yefu1681668/stm32-weather-clock/README.md

# STM32 智能天气时钟（FreeRTOS 版）

基于 **STM32F103C8T6** 的桌面天气时钟：ESP32-C3（AT 固件）联网获取天气与时间，1.8" ST7735 彩屏显示时钟、气温与湿度，RTC 独立走时，FreeRTOS 多任务调度。

本项目为「裸机版天气时钟」的 FreeRTOS 重构版本，同时也是后续 **OTA 远程升级** 改造的起点。

> **状态：全部功能与多任务架构均已在真机验证通过**（2026-11-10），详见文末「真机验证记录」与「演示：断网 A/B 对比」。

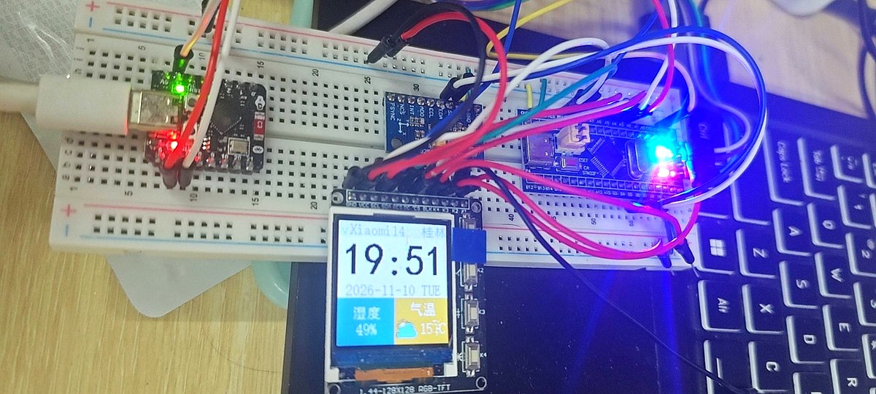
[picture p1: docs/hardware.jpg]
实物接线：STM32F103C8T6 + ST7735 彩屏 + ESP32-C3 面包板系统


> 实物照片：面包板上的 C8T6、ST7735 彩屏、ESP32-C3 与杜邦线连接。

---

## 功能特性

- **联网天气**：ESP32-C3 通过 AT 指令连接 2.4 GHz WiFi，向心知天气请求实况（天气现象、温度）与当天湿度
- **SNTP 对时**：启动时用 `AT+CIPSNTPTIME?` 取本地时间写入 RTC；RTC 由 LSE 32.768 kHz 晶振走时，掉电保持
- **界面**：128×128 分区布局 —— 状态栏（WiFi 名 + 城市）、48 px 大字号时间、日期行、湿度面板、气温面板
- **湿度**：来自天气 API 的**城市相对湿度**（板上没有湿度传感器），显示如 `49%`
- **气温**：天气 API 实况温度 + 对应的 24×24 天气图标（晴 / 多云 / 阴 / 雨 / 雪 / 风）
- **三任务架构**：`ui_task` / `net_task` / `heartbeat_task` 分工，队列传数据、互斥量保护屏幕、二值信号量做启动闸门
- **断网不冻屏**：AT 指令最长 20 s 的等待被隔离在低优先级网络任务，联网卡住时时间、冒号与 LED 心跳照常
- **栈水位监控**：每 20 s 用 `uxTaskGetStackHighWaterMark()` 采样，低于 64 word 时 LED 快闪告警

> 说明：MPU6050 驱动仍在工程中并完成了初始化，但当前界面不读取它 —— 它的温度是**芯片结温**（比室温高 10 ℃ 以上），不是环境温度，显示出来会误导，因此已停用。姿态自动翻转功能尚未实现。

## 硬件清单

| 器件 | 型号 / 规格 | 说明 |
|---|---|---|
| 主控 | STM32F103C8T6 | 64 KB Flash / 20 KB RAM，72 MHz |
| 显示 | ST7735 1.8" TFT | 128×128，SPI 接口，RGB565 |
| 联网 | ESP32-C3 开发板 | 预烧精简版 AT 固件，UART 115200，自带 Type-C 供电 |
| 姿态 | MPU6050 | 六轴，软件 I2C（当前仅初始化，未使用读数） |
| 存储 | W25Q80（1 MB SPI Flash） | 存放 6 张天气图标，见下文「图标外置到 W25Q」 |
| 走时 | 32.768 kHz 晶振 | 接 PC14 / PC15，供 RTC 使用 |
| 下载 | ST-Link V2 | SWD 四线 |

## 接线表

引脚定义直接取自驱动代码（`driver/` 下各文件的 `#define`），与实际接线一致。

### ST7735 显示屏（SPI1）

| 信号 | 引脚 | 说明 |
|---|---|---|
| SCK | PA5 | SPI1 时钟，18 MHz（72 MHz ÷ 4） |
| MOSI | PA7 | SPI1 数据输出 |
| CS | PA4 | 片选，低有效 |
| DC | PB1 | 命令/数据选择 |
| **RES** | **PB0** | **硬复位，必须接！漏接 = 背光亮但纯白屏** |
| BLK | PB10 | 背光，高电平点亮 |

> SPI1 配置为 Mode 3（CPOL=1, CPHA=2Edge）、单线发送主模式、软件 NSS。屏幕只写不读，因此未占用 MISO（PA6）。
> 像素数据当前使用**阻塞轮询发送**（`ST7735_USE_DMA = 0`），不经过 DMA，避免 DMA 未启动时永久死等。

### ESP32-C3（USART2）

| 信号 | 引脚 | 说明 |
|---|---|---|
| TX | PA2 | STM32 → ESP32 |
| RX | PA3 | ESP32 → STM32 |

> 波特率 115200，中断接收，接收缓冲 4096 B。注意不是 PA9/PA10（那是 USART1）。
> **TX / RX 必须交叉**，且 ESP32 与 STM32 **必须共地**。

### W25Q 图标 Flash（软件 SPI，独立于屏）

| 信号 | 引脚 | 说明 |
|---|---|---|
| CS | PB12 | 片选，低有效 |
| CLK | PB13 | 软件 SPI 时钟（Mode 0） |
| DI / MOSI | PB15 | 主 → 从 |
| DO / MISO | PA6 | 从 → 主 |
| VCC / GND | 3.3V / GND | **不能接 5V** |
| WP / HOLD | 3.3V 或悬空 | 接地会变成只读芯片 |

> 故意没有用硬件 SPI2：SPI1 已被显示屏占用且配置为单向 Mode 3，另开 SPI2 要牵动 DMA 与中断；图标只在刷新时才读，软件 SPI 的速度完全够，接线也更容易复现。
> 模块丝印常写 `DI` / `DO` 而不是 `MOSI` / `MISO`：**DI 是 MOSI，DO 是 MISO**，接反就是读 ID 全 0。

### MPU6050（软件 I2C）

| 信号 | 引脚 |
|---|---|
| SCL | PB6 |
| SDA | PB7 |

### 其他

| 器件 | 引脚 |
|---|---|
| 板载 LED | PC13 |
| RTC 晶振 | PC14 / PC15（LSE） |

## 软件架构

```
main()
 ├─ HAL_Init() / SystemClock_Config()       72 MHz（HSE 8 MHz × 9）
 ├─ MX_GPIO_Init() / MX_USART1_UART_Init()
 └─ freertos_start()
      ├─ xQueueCreate(6, weather_msg_t)     网络 → UI 的数据快照队列
      ├─ xSemaphoreCreateMutex()            保护 ST7735（两个任务都要写屏）
      ├─ xSemaphoreCreateBinary()           屏幕就绪闸门，初值 0
      ├─ esp_at_set_wait_hook(net_wait_1ms) 把驱动层 1ms 忙等换成 vTaskDelay(1)
      ├─ xTaskCreate(start_task) / vTaskStartScheduler()    TICK = 1000 Hz
      └─ start_task 建完三个任务后 vTaskDelete(NULL)
           ├─ ui_task         P3  640 word   只画屏 + 500 ms 时间节拍
           ├─ net_task        P2  384 word   WiFi / SNTP / HTTP，只发队列
           └─ heartbeat_task  P4  128 word   1 Hz LED + 20 s 栈水位采样
```

启动顺序（**顺序和闸门都很重要**）：

```
ui_task:   led_init → st7735_init → rtc_init → mpu6050_init
        → 画静态框架 / 状态栏 / 日期 / 时间 / 湿度面板
        → xSemaphoreGive(g_lcd_ready)          放行 net_task
        → 循环：非阻塞 xQueueReceive + 每 500 ms 刷时间/冒号

net_task:  xSemaphoreTake(g_lcd_ready)         屏没初始化好之前绝不碰屏
        → net_init_network()（进度行，写屏前先拿 g_lcd_mutex）
        → 依次发 MSG_WIFI_STATUS / MSG_NET_DONE / MSG_WEATHER / MSG_HUMIDITY
        → 循环：每 10 min 刷天气 + 对时，每 60 min 刷湿度
```

| 同步对象 | 类型 | 解决的问题 |
|---|---|---|
| `g_weather_q` | 队列（深度 6） | 网络数据与界面解耦；UI 用 `xQueueReceive(..., 0)` 非阻塞取，绝不因等网络而停摆 |
| `g_lcd_mutex` | 互斥量 | `net_task` 画开机进度、`ui_task` 画主界面共用 SPI，避免半帧交错 |
| `g_lcd_ready` | 二值信号量 | ESP32 串口在联网流程里才初始化，闸门保证进度行不会写进一块还没初始化的屏 |

**为什么做这次拆分（真实缺陷，不是为了用 RTOS 而用）**：`esp_at_send_command()` 的等待是 `while (rxready && timeout--) delay_ms(1)`，`AT+CWJAP` 上限 20 s、HTTP 10 s。原架构网络与画屏挤在同一个 `ui_task` 里，请求一卡就整屏冻结、时间不跳、LED 不闪。

**驱动层保持零 RTOS 依赖**：`esp_at.c` 不 include 任何 RTOS 头文件，只暴露一个 `esp_at_set_wait_hook()` 函数指针；任务层注册 `net_wait_1ms()`（`vTaskDelay(1)`），把每 1 ms 的忙等变成挂起一个 tick。系统 tick 是 1 kHz，任务总在 tick 边界被唤醒，超时仍按毫秒计。固定延时（500 / 2500 / 1000 ms）也走同一路径。

> **踩过的坑：低优先级饥饿。** 首版把 `heartbeat_task` 放在 P1（最低），真机出现「冒号照常闪、PC13 LED 完全不闪」——因为 `net_task`(P2) 忙等时始终就绪，`ui_task`(P3) 能抢占，而 P1 一次都调度不到。修复是三管齐下：等待钩子让出 CPU、心跳提到 P4（存活指示器必须独立于业务负载）、并给三个 `xTaskCreate` 补返回值检查（堆不足时以 100 ms 快闪报警，不再静默失败）。

任务参数：优先级 5 级（`configMAX_PRIORITIES = 5`）、最小栈 128 word、堆 8 KB（`heap_4`，三个任务栈与同步对象均从中动态分配）、`configUSE_MUTEXES = 1`、`INCLUDE_uxTaskGetStackHighWaterMark = 1`。

> 曾经的顺序 bug：`ui_update_weather()` 排在串口初始化之前，等于把 AT 命令发给一个还没打开的串口，会白等 10 秒，表现为「橙色面板空白」。现在已修正，并由 `g_lcd_ready` 从机制上杜绝。

### 图标外置到 W25Q（2026-11-11）

6 张天气图标原本是 `const uint16_t` 数组编进固件，**27 648 B 占掉 APP 分区的一大半**，导致 47 KB 的 OTA APP 分区装不下（超 104 B）。改造分三步：

1. **写驱动**：`driver/w25q/` —— 软件 SPI（Mode 0）、读 / 页写 / 4 KB 扇区擦除 / 跨页自动拆分 / 忙等待超时，全部带返回值，不静默失败。
2. **一次性烧录**：临时固件把 6 张图标（`icons.bin` 紧凑布局）写进 `0x010000` 并**逐字节读回比对**，屏上显示 `ICON OK 27648B` 即通过。烧完这段代码已删除，需要重烧时从提交 `357c842` 取回 `mdk/app/icon/*.c` 与旧版 `freertos_demo.c`。
3. **改绘图**：`draw_icon_flash()` 按**行**从 W25Q 读（每行 48 px = 96 B），2:1 抽样画成 24×24。**RAM 只多 96 B** —— 整张 4 608 B 放不进 C8T6 的 20 KB，六张 27 KB 更不可能。

存储布局（`app/icons_flash.h`，与 `icons_index.h` 一致）：

| 地址 | 内容 | 大小 |
|---|---|---|
| `0x000000` | 保留（参数 / 元数据） | 64 KB |
| `0x010000` | 6 张图标，间隔 `0x1200` | 27 648 B |
| `0x020000` | OTA 固件暂存区（已占位，待用） | ≤ 47 KB |

1 MB 的 W25Q80 用不到 15%，容量不是瓶颈。开机只读一次 JEDEC ID：不通就在日期行打红字 `W25Q FAIL`，通路则完全不打扰界面，图标画不出来时自动退化为「只有温度没有图标」的排版，不会白块也不会死机。

### OTA BootLoader 第一步（2026-11-11）

图标搬出去腾出空间后，开始把固件拆成两级。**这一步只做"能启动、能跳转"，升级通路还没接。**

内部 Flash 分区：

| 区域 | 起始地址 | 大小 | 当前占用 |
|---|---|---|---|
| Boot | `0x08000000` | 16 KB | 8 128 B（49.6%） |
| APP | `0x08004000` | 47 KB（`0xBC00`） | 22 564 B（46.9%） |
| 参数页 | `0x0800FC00` | 1 KB | 升级标志 / `boot_try` 计数 |

Boot 主流程：`HAL_Init` → 时钟（HSE 起不来就 10 Hz 快闪报错，不装死）→ 读参数页 → 校验 APP 起始处的 MSP/PC 是否落在 `0x08004000`~`0x20005000` 内 → **500 ms 常规窗口**（LED 5 Hz 快闪，可手动发 `U` 请求升级）→ 校验通过且无请求则跳转。

跳转做了三件容易被忽略的事：`__disable_irq()`、`SCB->VTOR = APP 地址`、`__set_MSP(APP 栈顶)` 之后才 `((void(*)(void))复位向量)()`。APP 侧 `main()` 开头也重设一次 `VTOR`，这样 APP 单独烧到 `0x08000000` 调试时行为不变。

**Boot 故意不驱动屏幕。** 它只有 8 KB，没有 ST7735 驱动，也不碰 PB10（背光）；`st7735_bl_on()` 是 APP 的 `st7735_init()` 最后一句。所以**只烧 Boot、或 APP 区还没有有效固件时，上电屏幕是全黑而不是白屏** —— 这是设计而非故障，此时唯一的指示是 PC13：

| PC13 表现 | 含义 |
|---|---|
| 5 Hz 快闪 0.5 秒后转为 APP 的 1 Hz | 正常：Boot 跑通并跳转成功 |
| 2 Hz 慢闪 | 在升级窗口里等上位机 / 正在收固件 |
| 一直 5 Hz 慢闪不停 | APP 校验不过（没烧、或没烧到 `0x08004000`）；发 `U` 可重新升级救砖 |
| 10 Hz 快闪 | 时钟起不来（HSE 异常） |

接 CH340 到 PA9/PA10（115200）可以看到 Boot 日志：版本、参数状态、APP 地址与有效长度、`jumping to app...`。Boot 用寄存器直接操作 USART1（`boot/boot_uart.c`），因为本工程 HAL 的 UART 模块是关着的 —— 这样做也省了 1~2 KB ROM。

> 第①步最初是固定等 3 秒，每次开机都白等；第②步改成 500 ms 按需等待，详见下节。

### OTA BootLoader 第二步：升级请求（2026-11-11）

第①步每次开机都要在 Boot 里白等 3 秒，而且**没有任何办法让 APP 主动回到 Boot**。这一步把两件事一起解决。

**三条进入升级等待的路径**

| 触发方式 | 适用场合 |
|---|---|
| APP 运行时串口发 `U` | 正常升级：APP 写参数页 `upgrade_req=1` → `NVIC_SystemReset()` → Boot 读到标志停住 |
| 上电后 500 ms 内串口发 `U` | APP 已经跑不起来时的手动入口（Boot 自己也能收命令） |
| 参数页里预先写好 `upgrade_req=1` | 上位机 / 第③步流程使用 |

**为什么标志必须跨复位存在**：复位会清空 RAM，Boot 和 APP 之间唯一的"信箱"就是 `0x0800FC00` 那 32 B 参数页。APP 侧直接复用 `boot/boot_param.c` + `boot_crc.c` + `boot_flash.c`（工程里新建 `Boot/Shared` 分组，IncludePath 加 `..\boot`），两边共用同一份结构体和 CRC，不会出现"APP 按 A 格式写、Boot 按 B 格式读"的错位。

**标志是一次性的**：Boot 一读到 `upgrade_req=1` 就立刻清 0 写回，再进入等待。不清的话升级结束后每次复位都会再停一次，板子就永远回不了 APP。清失败时**直接忽略这次请求**（宁可丢一次升级，也不让每次开机白等 30 秒）。正常开机绝不擦写参数页，避免磨损 Flash。

**超时回退**：`BOOT_UPGRADE_WAIT_MS = 30 s` 是「等第一个字节」的窗口；第③步已把它换成真正的固件接收状态机，30 s 内没等到上位机就 `timeout -> fallback to app`，误触发一次也不会变砖。

| 常量 | 值 | 位置 |
|---|---|---|
| `BOOT_WAIT_MS` | `3000 → 500` ms | `boot/boot_cfg.h` |
| `BOOT_UPGRADE_WAIT_MS` | `30000` ms | `boot/boot_cfg.h` |
| `BOOT_CMD_CHAR` | `'U'`（大小写都认） | `boot/boot_cfg.h` |

**APP 侧实现**（`mdk/app/app_upgrade.c`）：USART1 RXNE 中断只置一个 `volatile` 标志，不调用任何 FreeRTOS API；`heartbeat_task` 从 1 s 一次改为 **20 × 50 ms** 的节拍（LED 仍是 1 Hz），每 50 ms 查一次标志，命中就挂起调度器 → 擦写参数页 → `NVIC_SystemReset()`（不用关中断：APP 的 HAL 时基是 TIM7 中断，Flash 擦写靠 `HAL_GetTick()` 判超时，关中断会把时基冻住）。RX 脚 PA10 补了上拉，避免没接 CH340 时浮空噪声造成误触发。

**验证方法**（需要 CH340：TX→PA10、RX→PA9、共地，115200 8N1）

1. 两个 hex 都重烧，正常上电 → **约 0.5 秒**后屏亮（原来 3 秒），串口打印 `waiting 500 ms ('U' to upgrade)...` 后 `jumping to app...`。
2. 天气时钟跑起来后，串口助手发送一个字符 `U` → APP 打印 `[OTA] upgrade requested -> reboot to BootLoader` 并立刻复位。
3. Boot 打印 `upgrade_req found -> stay in boot`、`waiting for firmware 30000 ms...`，PC13 改为 **2 Hz 慢闪**，屏幕保持全黑（Boot 不驱动屏）。
4. 第②步当时是「30 秒后 `timeout -> fallback to app` 跳回天气时钟」；第③步之后这个窗口会被固件接收状态机接管，没接上位机时才走同样的超时回退。

> 没接 CH340 也能验证第 1 条：上电到屏亮明显变快，就说明 500 ms 窗口生效了。

### 11-14 真机串口日志与一个已知陷阱

烧完两个 hex 后，SSCOM 5.13.1 / COM14 / 115200 8N1 抓到（完整的一轮）：

```
===== OTA BootLoader v0.1 =====
param: fresh upgrade_req=0, boot_try=0
app @0x08004000 valid, size=47352
waiting 500 ms ('U' to upgrade)...
jumping to app...
```

逐行读：参数页是出厂态（`fresh`）、没有待处理的升级请求；`0x08004000` 的向量表合法；**`waiting 500 ms` 证明新版 Boot 确实在跑**，`BOOT_WAIT_MS` 已从 3 s 降到 500 ms；最后成功跳转，约 0.5 s 屏亮、天气时钟正常。

> 抓到两轮启动日志，第一轮少了 `waiting 500 ms` 那一行。这行在代码里是无条件打印的，所以大概率是 ST-Link 下载复位时 CH340 重新枚举丢了几个字节，不是固件问题。

**`size=47352` 不是固件大小，别被它骗了。** 真实 APP 只有 22 564 B。`boot_app_measure_size()` 扫的是「APP 区里最后一个非 0xFF 字节」的位置，而 Keil 的 Erase Sectors 只擦固件实际占用的页，后面还残留着迁到 `0x08004000` 之前那版 48 KB 固件的残骸，于是扫描一路顶到接近 `0xBC00`。`boot_app_check()` 只看向量表的 MSP / PC，跟这个数字无关，所以跳转完全正常。

已把日志措辞改成 `valid, scan_end=`，并在 `boot_jump.c` 里写明限制。**对第③步的硬约束**：CRC32 校验范围、擦除页数、从 W25Q 复制多少字节，都必须由上位机协议头里的 `length` 决定（或写进 W25Q 暂存区的固件头），**绝不能靠扫描 0xFF 推断长度** —— 否则会把残留垃圾一起算进去，校验永远对不上。

**验证 2 同日 16:54 也已通过。** APP 运行时串口发单个字符 `u`（SSCOM 勾了「加回车换行」，状态栏 `S:3` 说明实际发出 `u\r\n` 共 3 字节），抓到的关键信号：

```
[OTA] upgrade requested -> reboot to BootLoader
===== OTA BootLoader v0.1 =====
param: ok, upgrade_req=1, boot_try=0
...
upgrade_req found -> stay in boot
waiting for firmware 30000 ms...
timeout -> fallback to app
jumping to app...
```

| 信号 | 证明 |
|---|---|
| `[OTA] upgrade requested` | APP 的 USART1 RXNE 中断收到命令；代码等 `TC` 标志把提示发完才复位，这行不会缺字 |
| `param: ok, upgrade_req=1` | 参数页写入成功、magic + CRC 合法，**标志跨复位活了下来**（`fresh` → `ok`） |
| `upgrade_req found -> stay in boot` | Boot 读到标志、清 0 写回、进入升级等待 |
| `waiting for firmware 30000 ms...` | 30 s 窗口生效；PC13 2 Hz 慢闪、屏幕全黑（Boot 不驱动屏） |
| `timeout -> fallback to app` + `jumping to app...` | 请求了但没接上位机也能自己回 APP，**误触发不变砖** |

发小写 `u` 也能命中：`BOOT_CMD_CHAR` 是 `'U'`，Boot 与 APP 两处判断都同时接受 `'U' + 0x20`。这一轮日志里的 `size=` 仍是旧措辞，因为烧的还是上一版 Boot —— 上面 `scan_end` 的改动只是注释 / 文案，不影响功能，不用专门重烧。

**再按一次 RESET 可以做第三个确认**：参数页应显示 `param: ok, upgrade_req=0`（`ok` 而非 `fresh`），证明那个一次性标志确实被 Boot 清掉了，下次开机不会又白等 30 秒。

### OTA BootLoader 第三步：串口固件升级（2026-11-14）

第②步那个 30 秒窗口只是空等，这一步把它换成真正的升级状态机：**串口收固件 → W25Q 暂存 → CRC32 校验 → 擦写 APP 区 → 复位**。

**为什么必须经过 W25Q**：C8T6 只有 20 KB SRAM，而一版 APP 固件 22 564 B，根本不可能整包收进 RAM。所以每收到一帧就立刻顺序写进外部 Flash，收完再从 W25Q 流式读回来算 CRC32。这个约束反而带来一个关键安全性质 —— **CRC32 通过之前，APP 区一个字节都不会被擦**：传坏包、断线、中途断电，板子都还留着原来能跑的固件。

**镜像布局**（W25Q `0x020000` 起，与图标区 `0x010000` 隔着 64 KB）

| 偏移 | 大小 | 内容 |
|---|---|---|
| `+0x00` | 32 B | 镜像头：`magic "OTA2"` / `length` / `crc32` / `version` / 保留 |
| `+0x20` | N B | 固件原始数据（从 `0x08004000` 起的连续映像） |

`length` 只能来自这个头（上位机解析 Intel HEX 时按「最后一个写过的地址」计算），**绝不靠扫 0xFF 推断** —— 这正是 11-14 日志里 `size=47352` 那个坑。

**串口分帧**（115200 8N1）

```
SOF 0xA5 | TYPE 1B | SEQ 2B(小端) | LEN 2B(小端) | PAYLOAD <=128B | CRC16 2B(小端)
```

| TYPE | PAYLOAD | Boot 的动作 |
|---|---|---|
| `0x01` HEAD | 32 B | 校验 magic / length → 擦暂存扇区 → 把头写进 W25Q |
| `0x02` DATA | ≤128 B | 顺序写 W25Q `+0x20+offset`，回 ACK |
| `0x03` END | 0 B | 校验字节数收齐后进入提交流程 |

应答是单字节：`0x06` ACK / `0x15` NAK（重发本帧）/ `0x07` DONE（成功，即将复位）/ `0x1B` ABORT。CRC16-CCITT-FALSE（poly `0x1021`，init `0xFFFF`）覆盖 `TYPE..PAYLOAD`，不含 SOF；**整包完整性由 CRC32 负责**。上位机最多重发 3 次，Boot 遇到「重复上一帧」直接回 ACK，能容忍 ACK 丢失。

**为什么帧内绝不 `HAL_Delay`**：F1 的 USART 没有 FIFO，RXNE 只锁存 1 个字节，115200 下每 86.8 µs 就来一个。收帧途中插 10 ms 延时会把后面整帧丢光，所以从 SOF 开始的每个字节都是紧轮询读取，只有「还没进帧、在等 SOF」时才闪 LED。上位机也严格逐帧等 ACK，绝不连发。

**提交流程**（`boot/boot_ota.c` 的 `ota_commit()`）

1. 从 W25Q `+0x20` 起按 256 B 分块流式读，累加 CRC32，与镜像头比对。不符 → 打印 `CRC MISMATCH` 直接返回，**APP 区未动**。
2. `boot_flash_erase_range(APP_START_ADDR, APP_MAX_SIZE)` 擦**整个** APP 区 47 页，而不是只擦 `length` 覆盖的页 —— 顺带清掉迁址前那版 48 KB 旧固件的残骸，所以升级后开机日志的 `scan_end` 会从 47352 变成真实的 22564。
3. 从 W25Q 逐块读、按半字写回内部 Flash。
4. 内部 Flash 是内存映射的，直接按地址读回来**再算一次 CRC32**，抓「`HAL_FLASH_Program` 返回 OK 但实际没写进去」。
5. `boot_app_check()` 复核 MSP / PC → 参数页记 `app_size` / `app_crc32` / `boot_try=0` → 回 DONE → `NVIC_SystemReset()`。

**救砖入口**：万一擦写中途失败导致 APP 无效，Boot 会停在 5 Hz 慢闪；此时串口发一个 `U` 就能重进升级状态机再传一次，不需要 ST-Link。

| 文件 | 作用 |
|---|---|
| `boot/boot_ota.c/.h` | 分帧状态机、CRC16、W25Q 暂存、提交流程 |
| `boot/boot_uart.c/.h` | 从 `boot_main.c` 抽出的 USART1 底层，新增带超时的阻塞读 |
| `boot/delay.c/.h` | 让 `mdk/driver/w25q/w25q.c` **一行不改**就能被 Boot 复用（`delay_ms` → `HAL_Delay`） |
| `boot/boot_main.c` | 30 s 空等换成 `boot_ota_run()`；末尾 `while(1)` 加救砖入口 |
| `boot/boot_cfg.h` | 协议常量、`OTA_STAGING_ADDR 0x020000`、版本 v0.2 |
| `boot/startup_stm32f103xb.s` | 栈 1 KB → 2 KB（256 B 读缓冲 + 136 B 帧结构 + HAL 擦写调用栈） |
| `mdk_boot/BootLoader.uvprojx` | 新增 `W25Q (shared with APP)` 分组，直接引用 `..\mdk\driver\w25q\w25q.c` |

**上位机**：`tools/ota_send.py` + `tools/ota_uart.py`。本机 pip 装不上 pyserial，所以串口层用 `ctypes` 直接调 Windows `kernel32`（`CreateFileW` / `SetCommState` / `ReadFile` / `WriteFile`），**零第三方依赖**。脚本负责解析 Keil 的 Intel HEX、加镜像头、发 `U` 触发、逐帧等 ACK，并实时把 Boot 日志打印出来 —— 应答是控制码（`0x06`/`0x15`/`0x07`/`0x1B`），日志全是可打印 ASCII，两者不会混淆。

```bash
python tools/ota_send.py --port COM14
python tools/ota_send.py --port COM14 --hex mdk/Objects/Freertos的嵌入式智能天气时钟.hex
```

默认升级包就是**当前这份 APP 的 hex 还原出来的 bin**（22 564 B / 177 帧 / CRC32 `0xC05D9226`）。功能不变，但完整验证了「擦 → 写 → 读回校验 → 复位 → 跳转」整条链，而且 `scan_end` 的变化是肉眼可见的证据。

**验证方法（代码完成，真机验证待补）**

1. 只重烧 **Boot v0.2**（`mdk_boot`，`F7` → `F8`，Erase Sectors）；APP 源码与 hex **逐字节未变，不用重烧**。
2. 关掉串口助手，接好 CH340（TX→PA10 / RX→PA9 / 共地），运行 `python tools/ota_send.py --port COM14`。
3. 期望日志：`[OTA] W25Q id=0x00EF4014` → `[OTA] HEAD len=22564` → 每 4 KB 一条 `recv ...` → `[OTA] crc32 ok, erasing APP 47 KB...` → `[OTA] write 22564 B, readback crc ok` → `[OTA] DONE, resetting...`。
4. 复位后：`===== OTA BootLoader v0.2 =====`、`app @0x08004000 valid, scan_end=22564`（不再是 47352）、`jumping to app...`，天气时钟界面正常。

> 尚未验证：坏包 / 断电时「APP 区不被动」这条安全性，以及第④步的 `boot_try` 失败保护。

## 目录结构

```
weather_clock/
├── Core/                    CubeMX 生成的应用与 HAL 配置
│   ├── Inc/                 main.h / FreeRTOSConfig.h / HAL 配置
│   └── Src/                 main.c / gpio.c / usart.c / stm32f1xx_it.c
├── Drivers/                 STM32F1 HAL 库 + CMSIS（ST 官方，未改动）
├── FreeRTOS/                内核源码（tasks / queue / list）+ heap_4 + ARM_CM3 port
├── docs/                    实物照片 + 断网 A/B 对比演示 GIF
│   ├── hardware.jpg / screen.jpg
│   └── demo-offline.gif / demo-online.gif
├── boot/                    OTA BootLoader 源码（编到 0x08000000，16 KB 分区）
│   ├── boot_main.c          主流程：时钟 → 参数 → 500 ms 窗口 → 升级状态机/跳转
│   ├── boot_jump.c          MSP/PC 合法性检查 + 关中断 + 设 VTOR + 跳转
│   ├── boot_flash.c         内部 Flash 擦写 + APP 有效长度测量
│   ├── boot_param.c         参数页（0x0800FC00）读写
│   ├── boot_crc.c           CRC32（poly 0xEDB88320，位运算版省 ROM）
│   ├── boot_ota.c           第③步：分帧接收 / W25Q 暂存 / 校验 / 擦写 APP
│   ├── boot_uart.c          USART1 寄存器直写（日志 + 带超时收字节）
│   ├── delay.c              Boot 侧延时适配层，复用 APP 的 w25q.c
│   └── startup_stm32f103xb.s  Boot 专用启动文件（栈 2 KB）
├── mdk/                     Keil MDK 工程（APP）
│   ├── Freertos的嵌入式智能天气时钟.uvprojx
│   ├── app/                 应用层：天气解析、字库、开机动画、图标布局、app_upgrade.c
│   ├── driver/              外设驱动：st7735 / esp-at / mpu6050 / w25q / led / rtc
│   ├── user/                任务实现 freertos_demo.c、本地配置 wifi_config.h
│   └── Boot/Shared 分组     复用 ../boot 的参数页代码（同一份结构体与 CRC）
├── mdk_boot/                Keil MDK 工程（Boot，独立工程）
│   └── BootLoader.uvprojx   含 W25Q (shared with APP) 分组
└── tools/                   OTA 上位机（零第三方依赖）
    ├── ota_send.py          解析 hex / 加镜像头 / 分帧发送 / 打印 Boot 日志
    └── ota_uart.py          ctypes 调 Windows kernel32 的串口层
```

工程文件使用 `..\Core`、`..\Drivers`、`..\FreeRTOS` 相对路径引用上层目录，因此**必须保持上述目录结构**，不可只复制 `mdk/`。

## 编译与烧录

1. **配置本地参数**：编辑 `mdk/user/wifi_config.h`，填入自己的 WiFi 账号与心知天气 API key：

   ```c
   #define WIFI_CFG_SSID        "你的WiFi名"          /* 必须 2.4 GHz */
   #define WIFI_CFG_PWD         "你的WiFi密码"
   #define WEATHER_CFG_API_KEY  "你的心知天气key"      /* seniverse.com 免费注册 */
   #define WEATHER_CFG_CITY     "guilin"
   ```

   > 仓库中该文件是占位符版本（`YOUR_WIFI_SSID` 等），不填无法联网，但能正常编译。照片与录屏里的 SSID 是实机调试用的真实热点名，配置文件本身不含任何真实凭据。

2. **打开工程**（现在是两个独立工程，先 Boot 后 APP）：
   - Boot：`mdk_boot/BootLoader.uvprojx`，IROM 起始 `0x08000000`，大小 `0x4000`
   - APP：`mdk/Freertos的嵌入式智能天气时钟.uvprojx`，IROM 起始 `0x08004000`，大小 `0xBC00`
3. **编译烧录**：`F7` 编译 → `F8` 下载（ST-Link，BOOT0 接 GND）。**两个都必须烧**，只烧 Boot 屏幕不会亮（Boot 不驱动屏幕，详见下节）。首次打开 Boot 工程如果弹 `No ULINK2/ME Device found`，是调试器默认选中了 ULINK2，在 `Options for Target → Debug → Use:` 里改成 `ST-Link Debugger` 即可。
4. **上电观察**：PC13 快闪约 0.5 秒（Boot 500 ms 窗口）→ 屏幕亮起、中间提示行依次走 `1/4 Init ESP...` → `2/4 STA Mode...` → `3/4 <SSID>...` → `4/4 SNTP Sync...` → 进入时钟界面，LED 转为稳定 1 Hz 慢闪

### 串口 OTA 升级（不用 ST-Link）

第③步做完之后，改 APP 不必再动 ST-Link：Boot 自己收固件、自己擦写 APP 区。

```bash
# 1. 关掉串口助手（COM 口只能被一个程序占用）
# 2. 确认 CH340：TXD->PA10、RXD->PA9、GND 共地
python tools/ota_send.py --port COM14
```

脚本会自动解析 `mdk/Objects/Freertos的嵌入式智能天气时钟.hex`、加 32 B 镜像头、发 `U` 让板子回 Boot、逐帧发送并实时打印 Boot 日志。**零第三方依赖**（串口层用 `ctypes` 调 Windows 系统 API）。

> Boot 只在改 `boot/` 目录时才需要用 ST-Link 重烧；日常改天气时钟只要编译 APP 生成新 hex，再跑一次上面的命令即可。协议细节与验证清单见「OTA BootLoader 第三步」。

### 排障提示（都是真机踩过的坑）

| 现象 | 原因与排查方向 |
|---|---|
| **背光亮、屏幕纯白** | **头号原因：RES 没接 PB0**，或 RES/DC 接反（PB0 与 PB1 是相邻两孔）。屏没被硬件复位唤醒，发什么命令都不响应 |
| 背光亮、有画面但卡住 | 检查 `net_init_network()` 顺序，AT 命令不能发在串口初始化之前 |
| 屏幕全黑 | 量 PB10 背光是否为高、VCC 是否 3.3 V |
| 顶部彩条都画不出来 | 用 `st7735_probe_bars()` 做最小路径测试（绕过上层绘图）；能出彩条 = 屏与 SPI 正常，问题在绘图层 |
| `ESP rx=0000` | ESP32 一个字节都没回：查 TX/RX 交叉、共地、EN/BOOT 脚、供电（不要用 ST-Link 的 3.3 V 带 ESP） |
| 时间显示 `08:xx` | `AT+SYSTIMESTAMP?` 不被固件支持导致时间戳为 0（1970+8h）。本工程已改用 `AT+CIPSNTPTIME?` |
| 图标是黑底 + 颜色错乱 | RGB565 图标数组是**小端**存放，且 `0x0000` 表示透明。本工程已按小端解析并跳过纯黑 |
| 湿度显示 `--%` | 湿度来自 `daily.json`，联网失败或接口未返回时会保持占位符，属正常容错 |
| 冒号闪但 LED 完全不闪 | 低优先级饥饿：`net_task` 长忙等期间心跳任务抢不到 CPU。本工程已用等待钩子 + 心跳 P4 修复 |
| LED 上电后 100 ms 快闪不停 | `ucHeap` 不足导致某个 `xTaskCreate` 失败，需扩堆或缩任务栈 |

> **AT 固件差异**：实测这颗 ESP32-C3 是裁剪版乐鑫 AT 固件，支持 `AT` / `CWMODE` / `CWJAP` / `CIPSNTPCFG` / `CIPSNTPTIME?` / `HTTPCGET`，但不支持 `AT+GMR` / `AT+VER` / `AT+CIPSTA?` / `AT+SYSTIMESTAMP?`。因此初始化采用「先用 `AT` 探活，其余尽力而为」的容错写法，不因某条可选命令报错就判定模组失联。

## 资源占用（实测，Keil V5.06 编译结果）

```
Program Size: Code=17948  RO-data=4356  RW-data=260  ZI-data=17812
```

| 项目 | 占用 | 总容量 | 使用率 |
|---|---|---|---|
| Flash（Code + RO + RW） | 22 564 B ≈ **22.0 KB** | 64 KB | 34.4% |
| RAM（RW + ZI） | 18 072 B ≈ **17.6 KB** | 20 KB | 88.2% |

> 数值含本地 WiFi 账号字符串，换用不同长度的 SSID 会有几十字节偏差。相比图标外置完成时（21 128 B）多出的约 1.4 KB，是第②步的参数页写入、CRC32、串口中断与升级请求逻辑。

**Boot 侧（`mdk_boot/BootLoader.uvprojx`）**

```
Program Size: Code=7788  RO-data=320  RW-data=20  ZI-data=2116
```

| 项目 | 占用 | 总容量 | 使用率 |
|---|---|---|---|
| Boot Flash | 8 128 B | 16 KB | 49.6% |
| Boot RAM | 2 136 B | 20 KB | 10.4% |

Boot 只链了 HAL 的 GPIO / RCC / FLASH / PWR / CORTEX 五类模块，没链 UART（串口用寄存器写）、没链屏驱动、没链 FreeRTOS。第③步把分帧状态机 + 软件 SPI Flash 驱动加进来后是 8 KB，16 KB 里还剩约 8 KB。RAM 2 136 B 里有一半是 2 KB 栈（第③步从 1 KB 调上来的），实测量足够。

**图标外置前后的体积账**（下表是 11-11 图标外置完成时的快照，之后第②步又加了约 1.4 KB；第③步只改 Boot，APP 侧 22 564 B 逐字节未变）

| | Flash | RO-data | RAM |
|---|---|---|---|
| 图标在片内（11-10） | 48 232 B | 32 052 B | 17 936 B |
| 图标在 W25Q（11-11） | **21 128 B** | **4 356 B** | 18 032 B |
| 变化 | **−27 104 B** | −27 696 B | +96 B |

- 省下的 27 KB 就是 6 张 48×48 RGB565 图标；RAM 只多了 `draw_icon_flash()` 里那一行 96 B 的读缓冲。
- 若套用 16 KB Boot + 47 KB APP 的 OTA 分区：APP 可用 **48 128 B**，当前占用 **22 564 B（46.9%）**，余量 **25 564 B** —— 从「超出 104 B」变成「装得下且有两个版本迭代空间」，OTA 的分区前提已经消除。
- RAM 只剩 **2.4 KB**（20 KB − 18 072 B）。移植 BootLoader 后若要与 APP 共享缓冲区，仍需重新核算任务栈与堆，不能直接把图标整张读进来。

## 真机验证记录（2026-11-10）

在 STM32F103C8T6 + ST7735 + ESP32-C3 实物上完成，屏幕实测显示：

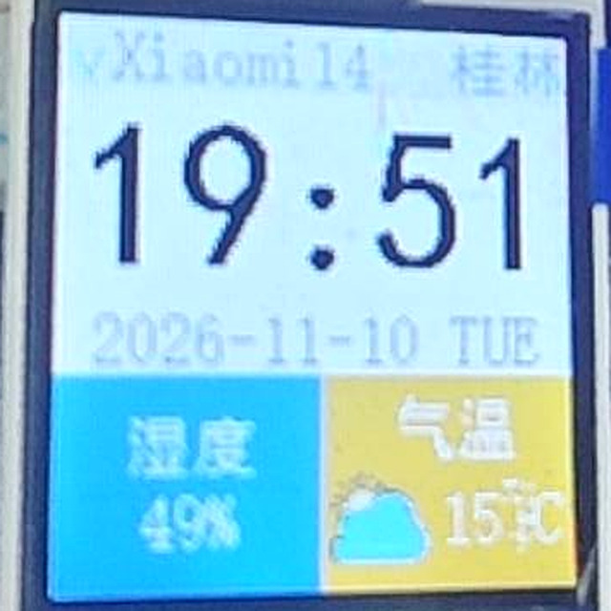
[picture p2: docs/screen.jpg]
屏幕特写：状态栏、时间、日期、湿度与气温面板


```
状态栏   Xiaomi14 | 桂林    ← WiFi 已连接
时间     19:51                ← 与北京时间一致，SNTP 对时正确
日期     2026-11-10 TUE
湿度     49%                  ← 心知 daily.json 返回
气温     15°C + 多云图标       ← 心知 now.json 返回，图标颜色/透明正常
```

已验证：SPI 显示链路、RGB565 字序、16×16 中文字模、窗口坐标、RTC 走时、USART2 中断接收、AT 指令建链、WiFi 入网、SNTP 对时、HTTP 取天气与湿度、FreeRTOS 三任务调度、队列/互斥量/信号量、`uxTaskGetStackHighWaterMark` 栈水位采样、LED 心跳。

**多任务专项验证**（关掉手机热点后按 RESET）：

| 观察项 | 结果 |
|---|---|
| LED 慢闪 3 次（启动标志）→ 稳定 1 Hz 慢闪 | 通过 |
| 联网卡住的几十秒内，中间冒号持续每秒闪一次 | 通过 |
| 同一时间窗内 PC13 LED 保持 1 Hz 慢闪、屏幕不冻结 | 通过 |
| 恢复热点后重启，天气 / 湿度 / 对时回来 | 通过 |
| 栈水位告警（快闪 3 次） | 未触发 |

**图标外置 W25Q 专项验证**（2026-11-11）：

| 观察项 | 结果 |
|---|---|
| 开机自检读到 JEDEC ID `EF4014`（W25Q80，1 MB） | 通过 |
| 6 张图标写入 `0x010000` 后按 64 B 分块读回逐字节比对，屏显 `ICON OK 27648B` | 通过 |
| 删除片内 6 个图标数组、固件从 47.1 KB 降到 20.6 KB 后重新烧录，橙色面板图标与温度照常显示 | 通过 |
| 图标颜色 / 透明 / 位置与删除前完全一致（同一份数据） | 通过 |
| W25Q 断开时的退化排版（不画图标、温度居中、日期行红字 `W25Q FAIL`） | 代码保证，未实测 |

排查过程中定位并修复的问题（均已在代码中）：

| # | 问题 | 修复 |
|---|---|---|
| 1 | RES 未接导致白屏 | 接线修正；驱动本来就有 `st7735_reset()` 硬件复位时序 |
| 2 | `rtc_init()` 裸等 LSE 无超时，晶振不起振即死机 | 加 2.3 s 超时并降级 LSI；`rtc_wait_for_rtoff()` 同样加超时 |
| 3 | `st7735_write_data()` 等 DMA TCIF 无超时 | 加超时兜底 + 默认切到阻塞写 |
| 4 | `ui_update_weather()` 早于串口初始化 | 调整顺序，先联网再取天气/湿度 |
| 5 | `AT+SYSTIMESTAMP?` 不被支持 → 时间变成 1970 | 改用 `AT+CIPSNTPTIME?` 解析，且不再重复 +8 h |
| 6 | 联网进度行擦掉日期行 | 联网结束后补画一次日期 |
| 7 | 湿度行超出 64 px 面板 4 px，蓝色侵入橙色面板 | 重排文字起点，收进面板边界 |
| 8 | 图标字节序错（大端→小端）+ 黑底 | 小端解析 + `0x0000` 视为透明 |
| 9 | 湿度无数据来源 | 新增 `daily.json` 请求与 `weather_parse_humidity()` |
| 10 | 网络请求卡住时整屏冻结 10 s | 拆出 P2 `net_task` + 队列解耦，UI 独立 500 ms 节拍 |
| 11 | 多任务首版「冒号闪但 LED 不闪」 | 低优先级饥饿：`esp_at` 等待钩子让出 CPU + 心跳提到 P4 |
| 12 | `xTaskCreate` 返回值被丢弃，堆不足时静默失败 | 逐个检查返回值，失败以 100 ms 快闪报警 |

## 演示：断网 A/B 对比

两段真机录屏取自**同一起点**（按 RESET 重启，RTC 无备份电池故从 `00:00` 起），已转正、裁到屏幕区域并转成 6 fps 优化 GIF（单文件均小于 GitHub 10 MB 上限）：

| 关掉手机热点 | 打开手机热点 |
|---|---|
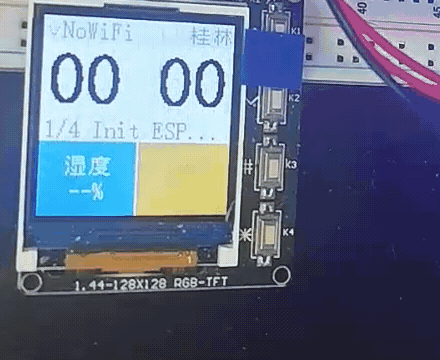
[picture p3: docs/demo-offline.gif]
断网时冒号与界面照常刷新
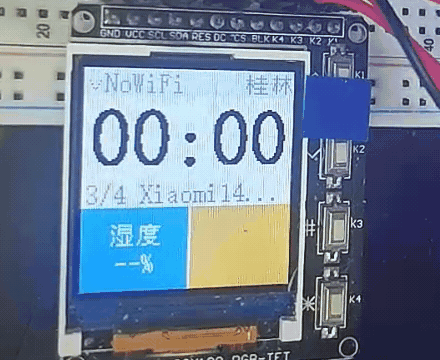
[picture p4: docs/demo-online.gif]
联网后 SNTP 对时与天气刷出
|  |  |
| 状态栏 `NoWiFi`，停在 `3/4 Xiaomi14...`，时间保持 `00:00` | `3/4` → SNTP 对时跳到 `21:02` → `21:03`，气温 `14°C` 与云图标刷出 |
| **冒号持续闪、屏幕不冻、LED 保持 1 Hz**：网络忙等被隔离在 P2，UI(P3) 与心跳(P4) 照常抢占 | 数据回来后只重画对应面板，时间节拍不受影响 |

> 断网那次湿度保持 `--%`、气温面板留空，是刻意的容错行为：请求失败时保留占位符，不覆盖旧值、不阻塞界面。湿度需单独请求 `daily.json`，本次演示未取到；上面那张静态特写里显示为 `49%`。
>
> 两段 GIF 循环播放，单文件 2.96 MB / 4.61 MB；原始 mp4 未在仓库中重复存放。

### OTA 两级启动与升级请求（2026-11-14）

| 验证项 | 结果 |
|---|---|
| 上电 → Boot 500 ms 窗口 → 跳 APP，约 0.5 s 屏亮 | 通过 |
| 串口 `waiting 500 ms ('U' to upgrade)...` + `jumping to app...` | 通过 |
| APP 运行时发 `u` → 打印 `[OTA] upgrade requested` 并复位 | 通过 |
| Boot 读到 `param: ok, upgrade_req=1` → `upgrade_req found -> stay in boot` | 通过 |
| 30 s 升级等待 → `timeout -> fallback to app` → 天气时钟恢复 | 通过，不变砖 |
| PC13 2 Hz 慢闪、屏幕全黑（Boot 不驱动屏） | 符合预期 |

详细日志与 `size=47352` 的解析见前文「11-14 真机串口日志与一个已知陷阱」。

## 当前进度与后续计划

- [x] 裸机版 → FreeRTOS 重构，Keil 编译 0 Error / 0 Warning
- [x] 全部功能真机验证通过（显示 / 对时 / 联网 / 天气 / 湿度）
- [x] **多任务重构**：`ui_task` / `net_task` / `heartbeat_task` + 队列 / 互斥量 / 二值信号量 / 栈水位监控，真机验证通过
- [x] **图标外置到 W25Q**：27 KB 图标移出片内 Flash，固件 48 232 B → 21 128 B，`ICON OK 27648B` 逐字节校验通过
- [x] **BootLoader 骨架（第①步）**：`boot/` + `mdk_boot/` 独立工程，16 KB 分区、参数页、MSP/PC 校验、3 秒窗口、VTOR 跳转；APP 已迁到 `0x08004000`，真机两级启动通过
- [x] **第②步：升级请求（11-14 真机全链路通过）**：APP 串口 `U` → 写参数页 `upgrade_req` → 复位回 Boot；Boot 窗口 3 s → 0.5 s，清一次性标志 + 30 s 超时回退不变砖
- [x] **第③步：串口固件升级（代码完成，真机验证待补）**：`tools/ota_send.py` 分帧发 bin → Boot 写 W25Q `0x020000` 暂存 → CRC32 → 擦整个 APP 区 → 写回 + 读回校验 → 复位；长度由镜像头给出、不扫 0xFF，CRC 通过前 APP 区不被动，另留了发 `U` 救砖入口
- [ ] 第④步：失败保护（`boot_try` 计数、APP 无效停 Boot、超限不跳转），故意传坏包验证不变砖

## 说明

- `mdk/user/wifi_config.h` 在仓库中为占位符版本。本地填入真实值后，建议执行
  `git update-index --skip-worktree mdk/user/wifi_config.h` 避免敏感信息被提交。
- `Drivers/` 与 `FreeRTOS/` 为 ST 官方与 FreeRTOS 官方源码，未做修改。
