yefu1681668/stm32-weather-clock/Core/Inc/main.h

#define LCD_CS_Pin       GPIO_PIN_4
#define LCD_CS_GPIO_Port GPIOA
#define LCD_DC_Pin       GPIO_PIN_1
#define LCD_DC_GPIO_Port GPIOB
#define LCD_RES_Pin      GPIO_PIN_0
#define LCD_RES_GPIO_Port GPIOB
#define LCD_BLK_Pin      GPIO_PIN_10
#define LCD_BLK_GPIO_Port GPIOB
#define LED_Pin          GPIO_PIN_13
#define LED_GPIO_Port    GPIOC
