yefu1681668/stm32-weather-clock/mdk/driver/st7735/st7735.c

#include <stdbool.h>
#include <stdint.h>
#include <string.h>
#include "stm32f1xx_hal.h"
#include "main.h"
#include "lcd_spi.h"
#include "st7735.h"
#include "stfonts.h"


#define CS_PORT     GPIOA
#define CS_PIN      GPIO_PIN_4
#define DC_PORT     GPIOB
#define DC_PIN      GPIO_PIN_1
#define RES_PORT    GPIOB
#define RES_PIN     GPIO_PIN_0
#define BLK_PORT    GPIOB
#define BLK_PIN     GPIO_PIN_10

#define GRAM_BUFFER_SIZE 4096

/* 像素数据的发送方式:
 *   1 = DMA (快, 但依赖 DMA 通道配置正确)
 *   0 = 纯阻塞轮询 TXE (慢一点, 完全不碰 DMA, 最稳)
 * 白屏排查期间先用 0: 如果阻塞能刷出画面, 说明 SPI 引脚/接线/屏都正常,
 * 白屏就是 DMA 那条路的问题; 确认链路 OK 后再改回 1 恢复速度。*/
#define ST7735_USE_DMA   0

// ST7735 Commands
#define ST7735_NOP     0x00
#define ST7735_SWRESET 0x01
#define ST7735_RDDID   0x04
#define ST7735_RDDST   0x09

#define ST7735_SLPIN   0x10
#define ST7735_SLPOUT  0x11
#define ST7735_PTLON   0x12
#define ST7735_NORON   0x13

#define ST7735_INVOFF  0x20
#define ST7735_INVON   0x21
#define ST7735_GAMSET  0x26
#define ST7735_DISPOFF 0x28
#define ST7735_DISPON  0x29
#define ST7735_CASET   0x2A
#define ST7735_RASET   0x2B
#define ST7735_RAMWR   0x2C
#define ST7735_RAMRD   0x2E

#define ST7735_PTLAR   0x30
#define ST7735_COLMOD  0x3A
#define ST7735_MADCTL  0x36

#define ST7735_FRMCTR1 0xB1
#define ST7735_FRMCTR2 0xB2
#define ST7735_FRMCTR3 0xB3
#define ST7735_INVCTR  0xB4
#define ST7735_DISSET5 0xB6

#define ST7735_PWCTR1  0xC0
#define ST7735_PWCTR2  0xC1
#define ST7735_PWCTR3  0xC2
#define ST7735_PWCTR4  0xC3
#define ST7735_PWCTR5  0xC4
#define ST7735_VMCTR1  0xC5

#define ST7735_RDID1   0xDA
#define ST7735_RDID2   0xDB
#define ST7735_RDID3   0xDC
#define ST7735_RDID4   0xDD

#define ST7735_PWCTR6  0xFC

#define ST7735_GMCTRP1 0xE0
#define ST7735_GMCTRN1 0xE1

#define CMD_DELAY      0xFF
#define CMD_EOF        0xFF


static const uint8_t init_cmd_list[] =
{
    0x11,  0,
    CMD_DELAY, 12,
    0xB1,  3,  0x01, 0x2C, 0x2D,
    0xB2,  3,  0x01, 0x2C, 0x2D,
    0xB3,  6,  0x01, 0x2C, 0x2D, 0x01, 0x2C, 0x2D,
    0xB4,  1,  0x07,
    0xC0,  3,  0xA2, 0x02, 0x84,
    0xC1,  1,  0xC5,
    0xC2,  2,  0x0A, 0x00,
    0xC3,  2,  0x8A, 0x2A,
    0xC4,  2,  0x8A, 0xEE,
    0xC5,  1,  0x0E,
    0x36,  1,  0xC8,
    0xE0,  16, 0x0F, 0x1A, 0x0F, 0x18, 0x2F, 0x28, 0x20, 0x22, 0x1F, 0x1B, 0x23, 0x37, 0x00, 0x07, 0x02, 0x10,
    0xE1,  16, 0x0F, 0x1B, 0x0F, 0x17, 0x33, 0x2C, 0x29, 0x2E, 0x30, 0x30, 0x39, 0x3F, 0x00, 0x07, 0x03, 0x10,
    0x2A,  4,  0x00, 0x00, 0x00, 0x7F,
    0x2B,  4,  0x00, 0x00, 0x00, 0x9F,
    0xF6,  1,  0x00,
    0x3A,  1,  0x05,
    0x29,  0,

    CMD_DELAY, CMD_EOF,
};

static volatile bool spi_async_done;
static uint8_t gram_buff[GRAM_BUFFER_SIZE];


static void spi_on_async_finish(void)
{
    spi_async_done = true;
}

static void st7735_select(void)
{
    HAL_GPIO_WritePin(CS_PORT, CS_PIN, GPIO_PIN_RESET);
}

void st7735_unselect(void)
{
    HAL_GPIO_WritePin(CS_PORT, CS_PIN, GPIO_PIN_SET);
}

static void st7735_reset(void)
{
    HAL_GPIO_WritePin(RES_PORT, RES_PIN, GPIO_PIN_RESET);
    delay_ms(2);
    HAL_GPIO_WritePin(RES_PORT, RES_PIN, GPIO_PIN_SET);
    delay_ms(150);
}

void st7735_bl_on(void)
{
    HAL_GPIO_WritePin(BLK_PORT, BLK_PIN, GPIO_PIN_SET);
}

void st7735_bl_off(void)
{
    HAL_GPIO_WritePin(BLK_PORT, BLK_PIN, GPIO_PIN_RESET);
}

static void st7735_write_cmd(uint8_t cmd)
{
    HAL_GPIO_WritePin(DC_PORT, DC_PIN, GPIO_PIN_RESET);
    lcd_spi_write(&cmd, 1);
}

static void st7735_write_data(uint8_t *data, size_t size)
{
    HAL_GPIO_WritePin(DC_PORT, DC_PIN, GPIO_PIN_SET);

#if ST7735_USE_DMA
    uint32_t guard;

    lcd_spi_write_async(data, size);
    /* 轮询DMA完成标志, 不依赖中断 (FreeRTOS下中断等待不可靠)
     * 原代码为裸 while, DMA 一旦不启动就会永久卡死; 这里加超时兜底,
     * 便于定位"到底是DMA没跑, 还是屏没显示"。*/
    guard = 400000UL;
    while (((DMA1->ISR & DMA_ISR_TCIF3) == 0) && (--guard != 0))
        ;
    DMA1->IFCR = DMA_IFCR_CTCIF3;

    guard = 400000UL;
    while (((SPI1->SR & SPI_SR_BSY) != 0) && (--guard != 0))
        ;
#else
    /* 阻塞写: 不经过 DMA, 直接往 DR 里塞字节。
     * 这条路能通就证明 SCK/MOSI/CS/DC 全对、屏能正常接收;
     * 走这条路还是白屏, 那就与软件无关, 一定是接线或屏本身。
     * 超时值要小: 异常时若每字节白等几十毫秒, 刷一屏会像死机一样停十几分钟。*/
    for (size_t i = 0; i < size; i++)
    {
        uint32_t guard = 2000UL;
        while (((SPI1->SR & SPI_SR_TXE) == 0) && (--guard != 0))
            ;
        if (guard == 0)
            return;                     /* SPI 异常, 不死等 */
        *(volatile uint8_t *)&SPI1->DR = data[i];
    }

    uint32_t guard = 2000UL;
    while (((SPI1->SR & SPI_SR_BSY) != 0) && (--guard != 0))
        ;
#endif
}

static void st7735_exec_cmds(const uint8_t *cmd_list)
{
    while (1)
    {
        uint8_t cmd = *cmd_list++;
        uint8_t num = *cmd_list++;
        if (cmd == CMD_DELAY)
        {
            if (num == CMD_EOF)
                break;
            else
                delay_ms(num * 10);
        }
        else
        {
            st7735_write_cmd(cmd);
            if (num > 0)
            {
                st7735_write_data((uint8_t *)cmd_list, num);
            }
            cmd_list += num;
        }
    }
}

static void st7735_set_window(uint8_t x0, uint8_t y0, uint8_t x1, uint8_t y1)
{
    // column address set
    st7735_write_cmd(ST7735_CASET);
    uint8_t data[] = {0x00, x0 + ST7735_XSTART, 0x00, x1 + ST7735_XSTART};
    st7735_write_data(data, sizeof(data));

    // row address set
    st7735_write_cmd(ST7735_RASET);
    data[1] = y0 + ST7735_YSTART;
    data[3] = y1 + ST7735_YSTART;
    st7735_write_data(data, sizeof(data));

    // write to RAM
    st7735_write_cmd(ST7735_RAMWR);
}

static void st7735_pin_init(void)
{
    GPIO_InitTypeDef GPIO_InitStructure = {0};

    /* CS */
    GPIO_InitStructure.Pin = CS_PIN;
    GPIO_InitStructure.Mode = GPIO_MODE_OUTPUT_PP;
    GPIO_InitStructure.Speed = GPIO_SPEED_FREQ_HIGH;
    HAL_GPIO_Init(CS_PORT, &GPIO_InitStructure);
    HAL_GPIO_WritePin(CS_PORT, CS_PIN, GPIO_PIN_SET);

    /* DC */
    GPIO_InitStructure.Pin = DC_PIN;
    HAL_GPIO_Init(DC_PORT, &GPIO_InitStructure);
    HAL_GPIO_WritePin(DC_PORT, DC_PIN, GPIO_PIN_RESET);

    /* RES */
    GPIO_InitStructure.Pin = RES_PIN;
    HAL_GPIO_Init(RES_PORT, &GPIO_InitStructure);
    HAL_GPIO_WritePin(RES_PORT, RES_PIN, GPIO_PIN_RESET);

    /* BLK */
    GPIO_InitStructure.Pin = BLK_PIN;
    HAL_GPIO_Init(BLK_PORT, &GPIO_InitStructure);
    HAL_GPIO_WritePin(BLK_PORT, BLK_PIN, GPIO_PIN_RESET);
}

void st7735_init(void)
{
    __HAL_RCC_GPIOA_CLK_ENABLE();
    __HAL_RCC_GPIOB_CLK_ENABLE();

    lcd_spi_init();
    lcd_spi_send_finish_register(spi_on_async_finish);
    st7735_pin_init();

    st7735_reset();

    st7735_select();
    st7735_exec_cmds(init_cmd_list);
    st7735_unselect();

    st7735_bl_on();
}

/* ------------------------------------------------------------------
 * 调试探针: 彩条
 * 在屏幕顶部画 4 个 32x32 实心块: 红 绿 蓝 白。
 * 这一段刻意不走 st7735_write_data / DMA / 窗口函数, 全部自己用阻塞写拼出来,
 * 目的只有一个: 用最少的代码路径判断"数据到底有没有送到屏上"。
 *   出现 红绿蓝白 彩条 -> SPI 链路正常, 白屏是上层绘图/DMA 的问题;
 *   仍然一片白         -> 数据没到屏, 属于接线/引脚/屏型号问题, 不要再改绘图代码。
 * 问题定位完可以删掉本函数及其调用。
 * ------------------------------------------------------------------*/
void st7735_probe_bars(void)
{
    static const uint16_t bars[4] = {0xF800, 0x07E0, 0x001F, 0xFFFF};  /* 红 绿 蓝 白 */
    uint8_t buf[64];
    uint8_t d[4];

    for (uint8_t b = 0; b < 4; b++)
    {
        /* 16x16 而不是 32x32: 数据量只有 1/4, 即使 SPI 异常也能在
         * 几十毫秒内走完, 不会让整机看起来"卡死"。*/
        uint16_t x = b * 16;
        uint16_t w = 16, h = 16;
        uint32_t total;

        for (uint32_t i = 0; i < sizeof(buf); i += 2)
        {
            buf[i]     = (uint8_t)(bars[b] >> 8);
            buf[i + 1] = (uint8_t)(bars[b] & 0xFF);
        }

        st7735_select();

        /* 列地址 */
        st7735_write_cmd(ST7735_CASET);
        d[0] = 0x00; d[1] = (uint8_t)(x + ST7735_XSTART);
        d[2] = 0x00; d[3] = (uint8_t)(x + w - 1 + ST7735_XSTART);
        HAL_GPIO_WritePin(DC_PORT, DC_PIN, GPIO_PIN_SET);
        lcd_spi_write(d, 4);

        /* 行地址 */
        st7735_write_cmd(ST7735_RASET);
        d[1] = (uint8_t)(0 + ST7735_YSTART);
        d[3] = (uint8_t)(h - 1 + ST7735_YSTART);
        HAL_GPIO_WritePin(DC_PORT, DC_PIN, GPIO_PIN_SET);
        lcd_spi_write(d, 4);

        /* 写显存 */
        st7735_write_cmd(ST7735_RAMWR);
        HAL_GPIO_WritePin(DC_PORT, DC_PIN, GPIO_PIN_SET);

        for (total = (uint32_t)w * h * 2; total > 0; )
        {
            uint16_t chunk = (total > sizeof(buf)) ? (uint16_t)sizeof(buf) : (uint16_t)total;
            lcd_spi_write(buf, chunk);
            total -= chunk;
        }

        st7735_unselect();
    }
}

void st7735_draw_pixel(uint16_t x, uint16_t y, uint16_t color)
{
    if (x >= ST7735_WIDTH || y >= ST7735_HEIGHT)
        return;

    uint8_t data[] = {color >> 8, color & 0xFF};

    st7735_select();
    st7735_set_window(x, y, x + 1, y + 1);
    st7735_write_data(data, sizeof(data));
    st7735_unselect();
}

static const uint8_t *st7735_find_font(const st_fonts_t *font, char ch)
{
    uint32_t bytes_per_line = (font->width + 7) / 8;

    for (uint32_t i = 0; i < font->count; i++)
    {
        const uint8_t *pcode = font->data + i * (font->height * bytes_per_line + 1);
        if (*pcode == ch)
        {
            return pcode + 1;
        }
    }

    return NULL;
}

void st7735_write_char(uint16_t x, uint16_t y, char ch, st_fonts_t *font, uint16_t color, uint16_t bgcolor)
{
    st7735_select();

    st7735_set_window(x, y, x + font->width - 1, y + font->height - 1);

    uint32_t bytes_per_line = (font->width + 7) / 8;

    uint8_t *pbuff = gram_buff;
    const uint8_t *fcode = st7735_find_font(font, ch);
    for (uint32_t row = 0; row < font->height; row++)
    {
        const uint8_t *pcode = fcode + row * bytes_per_line;
        for (uint32_t col = 0; col < font->width; col++)
        {
            uint8_t b = pcode[col >> 3];
            if ((b << (col & 0x7)) & 0x80)
            {
                *pbuff++ = color >> 8;
                *pbuff++ = color & 0xFF;
            }
            else
            {
                *pbuff++ = bgcolor >> 8;
                *pbuff++ = bgcolor & 0xFF;
            }
        }
    }

    st7735_write_data(gram_buff, pbuff - gram_buff);

    st7735_unselect();
}

void st7735_write_string(uint16_t x, uint16_t y, const char *str, st_fonts_t *font, uint16_t color, uint16_t bgcolor)
{
    while (*str)
    {
        if (x + font->width >= ST7735_WIDTH)
        {
            x = 0;
            y += font->height;
            if (y + font->height >= ST7735_HEIGHT)
            {
                break;
            }

            if (*str == ' ')
            {
                str++;
                continue;
            }
        }

        st7735_write_char(x, y, *str, font, color, bgcolor);
        x += font->width;
        str++;
    }

}

void st7735_write_font(uint16_t x, uint16_t y, st_fonts_t *font, uint32_t index, uint16_t color, uint16_t bgcolor)
{
    st7735_write_char(x, y, index, font, color, bgcolor);
}

void st7735_write_fonts(uint16_t x, uint16_t y, st_fonts_t *font, uint32_t index, uint32_t count, uint16_t color, uint16_t bgcolor)
{
    for (uint32_t i = index; i < count && i < font->count; i++)
    {
        if (x + font->width >= ST7735_WIDTH)
        {
            x = 0;
            y += font->height;
            if (y + font->height >= ST7735_HEIGHT)
            {
                break;
            }
        }
        st7735_write_font(x, y, font, i, color, bgcolor);
        x += font->width;
    }
}

void st7735_fill_rect(uint16_t x, uint16_t y, uint16_t w, uint16_t h, uint16_t color)
{
    if (x >= ST7735_WIDTH || y >= ST7735_HEIGHT)
        return;
    if (x + w - 1 >= ST7735_WIDTH)
        w = ST7735_WIDTH - x;
    if (y + h - 1 >= ST7735_HEIGHT)
        h = ST7735_HEIGHT - y;

    st7735_select();
    st7735_set_window(x, y, x + w - 1, y + h - 1);

    uint8_t pixel[2] = {color >> 8, color & 0xFF};
    for (uint32_t i = 0; i < w * h; i += GRAM_BUFFER_SIZE / 2)
    {
        uint32_t size = w * h - i;
        if (size > GRAM_BUFFER_SIZE / 2)
            size = GRAM_BUFFER_SIZE / 2;
        if (i == 0)
        {
            uint8_t *pbuff = gram_buff;
            for (uint32_t j = 0; j < size; j++)
            {
                *pbuff++ = pixel[0];
                *pbuff++ = pixel[1];
            }
        }
        st7735_write_data(gram_buff, size * 2);
    }

    st7735_unselect();
}

void st7735_fill_screen(uint16_t color)
{
    st7735_fill_rect(0, 0, ST7735_WIDTH, ST7735_HEIGHT, color);
}

void st7735_draw_image(uint16_t x, uint16_t y, uint16_t w, uint16_t h, const uint8_t *data)
{
    if ((x >= ST7735_WIDTH) || (y >= ST7735_HEIGHT))
        return;
    if ((x + w - 1) >= ST7735_WIDTH)
        return;
    if ((y + h - 1) >= ST7735_HEIGHT)
        return;

    st7735_select();
    st7735_set_window(x, y, x + w - 1, y + h - 1);
    st7735_write_data((uint8_t *)data, w * h * 2);
    st7735_unselect();
}
