yefu1681668/stm32-weather-clock/mdk/driver/esp-at/esp_at.c

#include <stdbool.h>
#include <stdint.h>
#include <string.h>
#include "main.h"
#include "delay.h"
#include "esp_usart.h"
#include "esp_at.h"

/* 轻量字符串拼接, 替代snprintf避免拉入printf库 */
static void str_append(char *dst, const char *src)
{
    while (*dst) dst++;
    while ((*dst++ = *src++) != '\0') { }
}


#define RX_BUFFER_SIZE  4096

#define RX_RESULT_OK    0
#define RX_RESULT_ERROR 1
#define RX_RESULT_FAIL  2


static uint8_t rxdata[RX_BUFFER_SIZE];
static uint32_t rxlen;
static bool rxready;
static uint8_t rxresult;

/* 调试: 最后一次响应长度 */
uint32_t esp_at_last_rxlen = 0;

/* 每 1ms 等待钩子: 默认 NULL = 裸机忙等, 不依赖任何 RTOS API。
 * RTOS 环境下由 freertos_start() 注册 vTaskDelay(1), 让出 CPU。 */
static void (*s_wait_hook)(void) = NULL;

void esp_at_set_wait_hook(void (*hook)(void))
{
    s_wait_hook = hook;
}

static void at_wait_1ms(void)
{
    if (s_wait_hook) s_wait_hook();
    else             delay_ms(1);
}

/* 固定延时同样走让出路径, 避免 RESTORE 后的 2.5s 把低优先级任务整段饿死 */
static void at_delay_ms(uint32_t ms)
{
    while (ms--) at_wait_1ms();
}


static void on_usart_received(uint8_t data)
{
    // 没有数据请求，不接受数据
    if (!rxready)
    {
        return;
    }

    // 接收数据，防止缓冲区溢出
    if (rxlen < RX_BUFFER_SIZE)
    {
        rxdata[rxlen++] = data;
    }
    else
    {
        rxresult = RX_RESULT_FAIL;
        rxready = false;
        return;
    }

    // 数据接收完毕判断
    if (data == '\n')
    {
        // 判断接收换行符是否为\r\n
        if (rxlen >= 2 && rxdata[rxlen - 2] == '\r')
        {
            // 收到OK
            if (rxlen >= 4 &&
                rxdata[rxlen - 4] == 'O' && rxdata[rxlen - 3] == 'K')
            {
                rxresult = RX_RESULT_OK;
                rxready = false;
            }
            else if (rxlen >= 7 &&
                     rxdata[rxlen - 5] == 'E' && rxdata[rxlen - 4] == 'R' &&
                     rxdata[rxlen - 3] == 'R' && rxdata[rxlen - 2] == 'O' &&
                     rxdata[rxlen - 1] == 'R')
            {
                rxresult = RX_RESULT_ERROR;
                rxready = false;
            }
        }
    }
}

bool esp_at_init(void)
{
    rxready = false;

    esp_usart_init();
    esp_usart_receive_register(on_usart_received);

    return esp_at_reset();
}

bool esp_at_send_command(const char *cmd, const char **rsp, uint32_t *length, uint32_t timeout)
{
    rxlen = 0;
    rxready = true;
    rxresult = RX_RESULT_FAIL;

    esp_usart_write_string(cmd);
    esp_usart_write_string("\r\n");

    /* 原来是纯 delay_ms(1) 忙等: ESP32 不应答时(最长 20s)本任务一直占着 CPU,
     * 低优先级任务会被完全饿死。注册 wait_hook 后改为每次挂起一个 tick,
     * 串口中断照常收数据, timeout 计数在 1kHz tick 下仍近似毫秒。 */
    while (rxready && timeout--)
    {
        at_wait_1ms();
    }
    rxready = false;

    esp_at_last_rxlen = rxlen;

    if (rsp)
    {
        *rsp = (const char *)rxdata;
    }
    if (length)
    {
        *length = rxlen;
    }

    return rxresult == RX_RESULT_OK;
}

bool esp_at_send_data(const uint8_t *data, uint32_t length)
{
    esp_usart_write_data((uint8_t *)data, length);

    return true;
}

bool esp_at_reset(void)
{
    /* ---- 1) 先用最基础的 "AT" 探测模组是否在线 ----
     * 所有 AT 固件都支持 AT 命令, 这是唯一可靠的存在性判据。
     * 实测本模组的固件为【精简版】: 不支持 AT+GMR / AT+VER / AT+?
     * / AT+CIPSTA, 但支持 AT / AT+CWMODE / AT+CWJAP / AT+RST,
     * 因此绝不能用带裁剪风险的命令来判断"模组在不在"。*/
    if (!esp_at_send_command("AT", NULL, NULL, 800))
    {
        at_delay_ms(500);                           /* 可能刚好在上电启动中, 再给一次机会 */
        if (!esp_at_send_command("AT", NULL, NULL, 800))
        {
            return false;                           /* 真的一字节都收不到 */
        }
    }

    /* ---- 2) 恢复出厂: 尽力而为, 失败也继续 ----
     * 精简固件收到 AT+RESTORE 可能直接回 ERROR。它只是"清配置",
     * 而 WiFi 账号密码由 wifi_config.h 每次启动重新 CWJAP 建立,
     * 所以不执行也不影响功能。*/
    if (esp_at_send_command("AT+RESTORE", NULL, NULL, 3000))
    {
        at_delay_ms(2500);                          /* RESTORE 会重启模组, 等它重新 ready */
    }

    /* ---- 3) 关回显 / 关存储: 纯优化项, 一律不判失败 ---- */
    esp_at_send_command("ATE0", NULL, NULL, 1000);
    esp_at_send_command("AT+SYSSTORE=0", NULL, NULL, 1000);

    /* 真正的连通性已经由第 1 步的 AT 验证过了 */
    return true;
}

bool esp_at_wifi_init(void)
{
    // 设置为station模式
    if (!esp_at_send_command("AT+CWMODE=1", NULL, NULL, 1000))
    {
        return false;
    }

    return true;
}
bool esp_at_wifi_connect(const char *ssid, const char *pwd)
{
    char cmd[64];

    // 连接wifi
    cmd[0] = '\0';
    str_append(cmd, "AT+CWJAP=\"");
    str_append(cmd, ssid);
    str_append(cmd, "\",\"");
    str_append(cmd, pwd);
    str_append(cmd, "\"");
    // WiFi连接可能需要较长时间, 超时20秒, 重试2次
    for (uint8_t retry = 0; retry < 2; retry++)
    {
        if (esp_at_send_command(cmd, NULL, NULL, 20000))
        {
            return true;
        }
        at_delay_ms(1000);
    }

    return false;
}

bool esp_at_get_http(const char *url, const char **rsp, uint32_t *length, uint32_t timeout)
{
    char cmd[128];

    cmd[0] = '\0';
    str_append(cmd, "AT+HTTPCGET=\"");
    str_append(cmd, url);
    str_append(cmd, "\"");
    if (!esp_at_send_command(cmd, rsp, length, 10000))
    {
        return false;
    }

    return true;
}

bool esp_at_sntp_init(void)
{
    // 设置为SNTP模式
    if (!esp_at_send_command("AT+CIPSNTPCFG=1,8,\"cn.ntp.org.cn\",\"ntp.sjtu.edu.cn\"", NULL, NULL, 1000))
    {
        return false;
    }

    // 查询sntp时间
    if (!esp_at_send_command("AT+CIPSNTPTIME?", NULL, NULL, 1000))
    {
        return false;
    }

    return true;
}

bool esp_at_get_time(uint32_t *timestamp)
{
    const char *rsp;
    uint32_t length;

    if (!esp_at_send_command("AT+SYSTIMESTAMP?", &rsp, &length, 1000))
    {
        return false;
    }

    char *sts = strstr(rsp, "+SYSTIMESTAMP:") + strlen("+SYSTIMESTAMP:");

    /* 轻量字符串转整数, 替代atoi避免拉入stdlib */
    uint32_t ts = 0;
    while (*sts >= '0' && *sts <= '9')
    {
        ts = ts * 10 + (*sts - '0');
        sts++;
    }
    *timestamp = ts;

    return true;
}

bool esp_at_wifi_get_ip(char ip[16])
{
    const char *rsp;
    if (!esp_at_send_command("AT+CIPSTA?", &rsp, NULL, 1000))
    {
        return false;
    }

    // 解析ip地址
    const char *pip = strstr(rsp, "+CIPSTA:ip:") + strlen("+CIPSTA:ip:");
    if (pip)
    {
        for (int i = 0; i < 16; i++)
        {
            if (pip[i] == '\r')
            {
                ip[i] = '\0';
                break;
            }
            ip[i] = pip[i];
        }
        return true;
    }

    return true;
}

bool esp_at_wifi_get_mac(char mac[18])
{
    const char *rsp;
    if (!esp_at_send_command("AT+CIPSTAMAC?", &rsp, NULL, 1000))
    {
        return false;
    }

    // 解析mac地址
    const char *pmac = strstr(rsp, "+CIPSTAMAC:mac:") + strlen("+CIPSTAMAC:mac:");
    if (pmac)
    {
        strncpy(mac, pmac, 18);
        return true;
    }

    return true;
}
