yefu1681668/stm32-weather-clock/mdk/driver/st7735/st7735.h

#ifndef __ST7735_H__
#define __ST7735_H__


#include <stdbool.h>
#include "stfonts.h"


#define ST7735_MADCTL_MY  0x80
#define ST7735_MADCTL_MX  0x40
#define ST7735_MADCTL_MV  0x20
#define ST7735_MADCTL_ML  0x10
#define ST7735_MADCTL_RGB 0x00
#define ST7735_MADCTL_BGR 0x08
#define ST7735_MADCTL_MH  0x04

// 1.44" display, default orientation
#define ST7735_IS_128X128 1
#define ST7735_WIDTH  128
#define ST7735_HEIGHT 128
#define ST7735_XSTART 2
#define ST7735_YSTART 3
#define ST7735_ROTATION (ST7735_MADCTL_MX | ST7735_MADCTL_MY | ST7735_MADCTL_BGR)

// 1.44" display, rotate right
/*
#define ST7735_IS_128X128 1
#define ST7735_WIDTH  128
#define ST7735_HEIGHT 128
#define ST7735_XSTART 3
#define ST7735_YSTART 2
#define ST7735_ROTATION (ST7735_MADCTL_MY | ST7735_MADCTL_MV | ST7735_MADCTL_BGR)
*/

// 1.44" display, rotate left
/*
#define ST7735_IS_128X128 1
#define ST7735_WIDTH  128
#define ST7735_HEIGHT 128
#define ST7735_XSTART 1
#define ST7735_YSTART 2
#define ST7735_ROTATION (ST7735_MADCTL_MX | ST7735_MADCTL_MV | ST7735_MADCTL_BGR)
*/

// 1.44" display, upside down
/*
#define ST7735_IS_128X128 1
#define ST7735_WIDTH  128
#define ST7735_HEIGHT 128
#define ST7735_XSTART 2
#define ST7735_YSTART 1
#define ST7735_ROTATION (ST7735_MADCTL_BGR)
*/

// Color definitions
#define	ST7735_BLACK   0x0000
#define	ST7735_BLUE    0x001F
#define	ST7735_RED     0xF800
#define	ST7735_GREEN   0x07E0
#define ST7735_CYAN    0x07FF
#define ST7735_MAGENTA 0xF81F
#define ST7735_YELLOW  0xFFE0
#define ST7735_WHITE   0xFFFF
#define ST7735_COLOR565(r, g, b) (((r & 0xF8) << 8) | ((g & 0xFC) << 3) | ((b & 0xF8) >> 3))


void st7735_unselect(void);
void st7735_init(void);

/* 背光控制：BLK = PB10，高电平点亮 */
void st7735_bl_on(void);
void st7735_bl_off(void);
void st7735_draw_pixel(uint16_t x, uint16_t y, uint16_t color);
void st7735_write_char(uint16_t x, uint16_t y, char ch, st_fonts_t *font, uint16_t color, uint16_t bgcolor);
void st7735_write_string(uint16_t x, uint16_t y, const char *str, st_fonts_t *font, uint16_t color, uint16_t bgcolor);
void st7735_write_font(uint16_t x, uint16_t y, st_fonts_t *font, uint32_t index, uint16_t color, uint16_t bgcolor);
void st7735_write_fonts(uint16_t x, uint16_t y, st_fonts_t *font, uint32_t index, uint32_t count, uint16_t color, uint16_t bgcolor);
void st7735_fill_rect(uint16_t x, uint16_t y, uint16_t w, uint16_t h, uint16_t color);
void st7735_fill_screen(uint16_t color);
void st7735_draw_image(uint16_t x, uint16_t y, uint16_t w, uint16_t h, const uint8_t *data);

/* 调试探针: 顶部画 红|绿|蓝|白 四色彩条(阻塞写, 不走DMA)。
 * 用来判断"数据到底有没有送到屏上", 排查完可删。*/
void st7735_probe_bars(void);


#endif // __ST7735_H__
