yefu1681668/stm32-weather-clock/mdk/driver/st7735/stfonts.c

#include <stdint.h>
#include "stfonts.h"


static const uint8_t font_ascii_8x16_data[][17] =
{
    {' ', 0x00, 0x00, 0x00, 0x00, 0x00, 0x00, 0x00, 0x00, 0x00, 0x00, 0x00, 0x00, 0x00, 0x00, 0x00, 0x00},
    {'!', 0x00, 0x00, 0x00, 0x10, 0x10, 0x10, 0x10, 0x10, 0x10, 0x10, 0x00, 0x00, 0x10, 0x10, 0x00, 0x00},
    {'"', 0x00, 0x12, 0x24, 0x24, 0x48, 0x00, 0x00, 0x00, 0x00, 0x00, 0x00, 0x00, 0x00, 0x00, 0x00, 0x00},
    {'#', 0x00, 0x00, 0x00, 0x12, 0x12, 0x12, 0x7E, 0x24, 0x24, 0x24, 0x7E, 0x24, 0x24, 0x24, 0x00, 0x00},
    {'$', 0x00, 0x00, 0x08, 0x3C, 0x4A, 0x4A, 0x48, 0x38, 0x0C, 0x0A, 0x0A, 0x4A, 0x4A, 0x3C, 0x08, 0x08},
    {'%', 0x00, 0x00, 0x00, 0x44, 0xA4, 0xA8, 0xA8, 0xB0, 0x54, 0x1A, 0x2A, 0x2A, 0x4A, 0x44, 0x00, 0x00},
    {'&', 0x00, 0x00, 0x00, 0x30, 0x48, 0x48, 0x48, 0x50, 0x6E, 0xA4, 0x94, 0x98, 0x89, 0x76, 0x00, 0x00},
    {'\'', 0x00, 0x60, 0x20, 0x20, 0x40, 0x00, 0x00, 0x00, 0x00, 0x00, 0x00, 0x00, 0x00, 0x00, 0x00, 0x00},
    {'(', 0x00, 0x02, 0x04, 0x08, 0x08, 0x10, 0x10, 0x10, 0x10, 0x10, 0x10, 0x08, 0x08, 0x04, 0x02, 0x00},
    {')', 0x00, 0x40, 0x20, 0x10, 0x10, 0x08, 0x08, 0x08, 0x08, 0x08, 0x08, 0x10, 0x10, 0x20, 0x40, 0x00},
    {'*', 0x00, 0x00, 0x00, 0x00, 0x10, 0x10, 0xD6, 0x38, 0x38, 0xD6, 0x10, 0x10, 0x00, 0x00, 0x00, 0x00},
    {'+', 0x00, 0x00, 0x00, 0x00, 0x00, 0x08, 0x08, 0x08, 0x7F, 0x08, 0x08, 0x08, 0x00, 0x00, 0x00, 0x00},
    {',', 0x00, 0x00, 0x00, 0x00, 0x00, 0x00, 0x00, 0x00, 0x00, 0x00, 0x00, 0x00, 0x60, 0x20, 0x20, 0x40},
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
    
	{'~',0x00,0x1C,0x22,0x22,0x1C,0x00,0x00,0x00,0x00,0x00,0x00,0x00,0x00,0x00,0x00,0x00},

	
};

st_fonts_t font_ascii_8x16 =
{
    .width = 8,
    .height = 16,
    .data = (const uint8_t *)font_ascii_8x16_data,
    .count = sizeof(font_ascii_8x16_data) / sizeof(font_ascii_8x16_data[0]),
};
