yefu1681668/stm32-weather-clock/mdk/app/boot_splash.h

#ifndef __BOOT_SPLASH_H__
#define __BOOT_SPLASH_H__


#include <stdint.h>


extern const uint16_t boot_splash_width;
extern const uint16_t boot_splash_height;
extern const uint8_t boot_splash_data[];


#endif /* __BOOT_SPLASH_H__ */
