yefu1681668/stm32-weather-clock/(commit log)

2026-11-04 feat: initial FreeRTOS port of the weather clock
    - Restructure into CubeMX layout: Core / Drivers / FreeRTOS alongside mdk/.
    The previous copy referenced ..\Core, ..\Drivers and ..\FreeRTOS but those
    directories were never copied, so the project could not build at all.
    - FreeRTOS runs with dynamic task creation (start_task -> ui_task), heap_4,
    1 kHz tick; weather / SNTP / IMU flip / RTC features kept intact.
    - Move WiFi credentials and the weather API key out of the source into
    user/wifi_config.h, which ships as placeholders in this repo.
    - Expose ST7735 backlight control and clear two compiler warnings.
    - Drop stale Core/Src/freertos_demo.c (superseded by user/freertos_demo.c,
    it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
    [boot_splash.h, conv_boot_splash.py, delay.c, delay.h, esp_at.c, esp_at.h, esp_usart.c]
2026-11-10 feat: verify all features on hardware and harden display/network drivers
    - Add humidity from seniverse daily.json (now.json has no humidity field)
    - Add CN glyphs for the outdoor temperature label; remove misleading MPU6050 die temperature
    - Fix icon RGB565 byte order (little-endian) and treat 0x0000 as transparent
    - Init ESP32 USART before any AT/HTTP request
    - Use AT+CIPSNTPTIME? instead of unsupported AT+SYSTIMESTAMP? (was 1970 epoch)
    - Redraw date after the network progress line erased it
    - Add timeouts to RTC LSE/RTOFF waits with LSI fallback, and to SPI/DMA writes
    - Tolerant AT init: probe with AT, optional commands are best-effort
    - Keep panel text inside 64px bounds
    - README: hardwar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
    [esp_at.c, lcd_spi.c, rtc.c, st7735.c, st7735.h, weather.c, weather.h]
2026-11-10 refactor(rtos): split into net/ui/heartbeat tasks with queue, mutex and binary semaphore
    - net_task (P2): HTTP/SNTP only, sends weather_msg_t through a queue; 10s timeout no longer freezes the UI
    - ui_task (P3): display only, non-blocking queue receive, 500ms time tick
    - heartbeat_task (P1): 1Hz LED plus uxTaskGetStackHighWaterMark sampling every 20s
    - g_lcd_mutex protects ST7735 (net draws progress, ui draws panels)
    - g_lcd_ready binary semaphore gates net_task until LCD init is done
    - enable configUSE_MUTEXES and INCLUDE_uxTaskGetStackHighWaterMark
    - Build: Code=15824 RO=32052 RW=248 ZI=17680, 0 Error / 0 Warning
2026-11-10 fix(rtos): stop low-priority starvation during AT wait; heartbeat must outrank net
    Symptom found on hardware: colon blinked but PC13 LED stayed off. esp_at_send_command() busy-waits with delay_ms(1) for up to 20s (CWJAP); net_task (P2) never blocks, so ui_task (P3) can preempt while heartbeat_task (P1) is starved forever.
    - Register a wait hook from the task layer so the driver stays RTOS-free: vTaskDelay(1) replaces every 1ms busy-wait, incl. fixed 500/2500/1000ms delays. Tick is 1kHz so timeout stays millisecond-accurate.
    - Raise heartbeat_task to P4: a liveness indicator must be independent of business load.
    - Check xTaskCreate return values; 100ms fast blink reports ucHeap exhaustion in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
    [esp_at.c, esp_at.h]
2026-11-11 feat: move weather icons to external W25Q flash
    6 张 48x48 RGB565 图标原本以 const 数组编进固件，占 27 648 B RO-data，
    导致 APP 分区（0x08004000, 48 128 B）超出 104 B，挡在 OTA 前面。
    - 新增 driver/w25q：软件 SPI(Mode0) 读/页写/4KB 扇区擦除/跨页拆分/超时
    - 新增 app/icons_flash.h：0x010000 起、间隔 0x1200 的图标布局，
    0x020000 预留 OTA 暂存区
    - draw_image_scaled() -> draw_icon_flash()：按行读，96 B 行缓冲，
    2:1 抽样画 24x24，RAM 仅 +96 B（整张 4608 B 放不进 20 KB）
    - 自检失败时不画图标（读回 0xFF 会变白块），日期行提示 W25Q FAIL
    - 移除 6 个 icon_weather_*.c（git 357c842 可恢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
    [icons_flash.h, stimage.h, w25q.c, w25q.h]
2026-11-11 feat: add OTA BootLoader skeleton, relocate APP to 0x08004000
    把固件拆成两级：Boot 16 KB @0x08000000 + APP 47 KB @0x08004000。
    boot/（HAL 版，仅 4 180 B / 16 KB）
    - boot_main.c: 时钟(HSE 失败 10Hz 快闪) -> 读参数页 -> 校验 APP -> 3s 窗口
    (LED 5Hz) -> 跳转；用寄存器直写 USART1 打日志，不链 HAL_UART 省 1-2 KB
    - boot_jump.c: MSP/PC 合法区间检查 + __disable_irq + SCB->VTOR + __set_MSP
    - boot_flash.c: 内部 Flash 擦写、APP 有效长度测量（不算 0xFF 尾部）
    - boot_param.c: 0x0800FC00 参数页（magic + CRC 保护，读坏按出厂值）
    - boot_crc.c: CRC32 poly 0xEDB88320 表驱动
    mdk_boot/：独立 Keil 工程，IROM 0x08000000/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
2026-11-11 feat: OTA step 2 - APP upgrade request, on-demand boot wait
    APP 现在能主动请求升级并复位回 Boot；开机不再固定白等 3 秒。
    Boot 侧
    - BOOT_WAIT_MS 3000 -> 500；新增 BOOT_UPGRADE_WAIT_MS 30000 / BOOT_CMD_CHAR 'U'
    - 新增 boot_uart_getchar()：非阻塞读 RXNE，先读 SR 再读 DR 清错误标志
    - 读到 upgrade_req=1 立即清 0 写回（一次性标志，防止每次复位都停 Boot）；
    清失败则忽略本次请求，宁可丢一次也不每次白等 30 s
    - 500 ms 窗口内串口发 'U' 也能手动进升级（APP 跑不起来时的兜底入口）
    - 30 s 升级等待（LED 2 Hz）暂做超时回退：timeout -> fallback to app，不变砖
    - 清 RX 残留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
2026-11-14 docs: record 11-14 boot serial log, clarify misleading APP size scan
    真机串口日志到手：waiting 500 ms -> jumping to app，两级启动通过，
    BOOT_WAIT_MS 3s->500ms 生效；APP 运行时发 U 回 Boot 尚未验证。
    发现日志里 size=47352 具有误导性：boot_app_measure_size() 扫的是
    「最后一个非 0xFF 字节」的位置，Keil Erase Sectors 只擦固件占用的页，
    APP 区后半段残留迁址前 48 KB 旧固件数据，于是扫描值被撑到接近 0xBC00
    （真实 APP 仅 22 564 B）。boot_app_check() 只看向量表 MSP/PC，与此无关，
    跳转正常，不是 bug；但第③步 CRC32/擦除/复制的长度绝不能靠扫 0xFF 推断，
    必须由上位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
    [boot_jump.c, boot_main.c]
2026-11-14 docs: step 2 fully verified on real hardware (11-14 16:54)
    APP 运行时串口发 u -> [OTA] upgrade requested -> 复位 ->
    Boot 读到 param: ok, upgrade_req=1 -> upgrade_req found -> 30s 等待 ->
    timeout -> fallback to app -> jumping to app，全链路真机通过。
    - fresh -> ok 证明参数页写入成功、标志跨复位存活
    - 小写 u 也命中（Boot/APP 两处都接受 'U'+0x20）
    - 超时回退验证：误触发一次不变砖
    - README: 11-14 小节补验证 2 判据表、新增 OTA 真机验证记录表、
    进度第②步改为真机全链路通过
    - 未改任何固件代码，无需重烧
    上次 7194a5e 因代理 502 未推送，本次一并补推。
2026-11-14 feat: OTA step 3 - serial firmware upgrade via W25Q staging
    把第②步的 30 s 空等换成真正的固件接收状态机，并配零依赖上位机。
    为什么必须经过 W25Q：C8T6 只有 20 KB SRAM，APP 固件 22 564 B 塞不进 RAM。
    每帧 128 B 立即写 W25Q 0x020000 暂存，收完流式读回算 CRC32，通过后才擦
    APP 区 —— CRC 通过前 APP 区一个字节都不动，坏包/断线/断电都不会变砖。
    协议（boot_cfg.h）
    - 帧: SOF 0xA5 | TYPE | SEQ(2,LE) | LEN(2,LE) | PAYLOAD<=128 | CRC16(2,LE)
    CRC16-CCITT-FALSE 覆盖 TYPE..PAYLOAD；TYPE 0x01 HEAD(32B)/0x02 DATA/0x03 END
    应答 0x06 ACK / 0x15 NAK / 0x07 DONE / 0x1B ABORT
    - 镜像头 32B: magic 'OTA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
